Meet2147/touch_smart_mirror/pics/smart-mirror-1.jpg

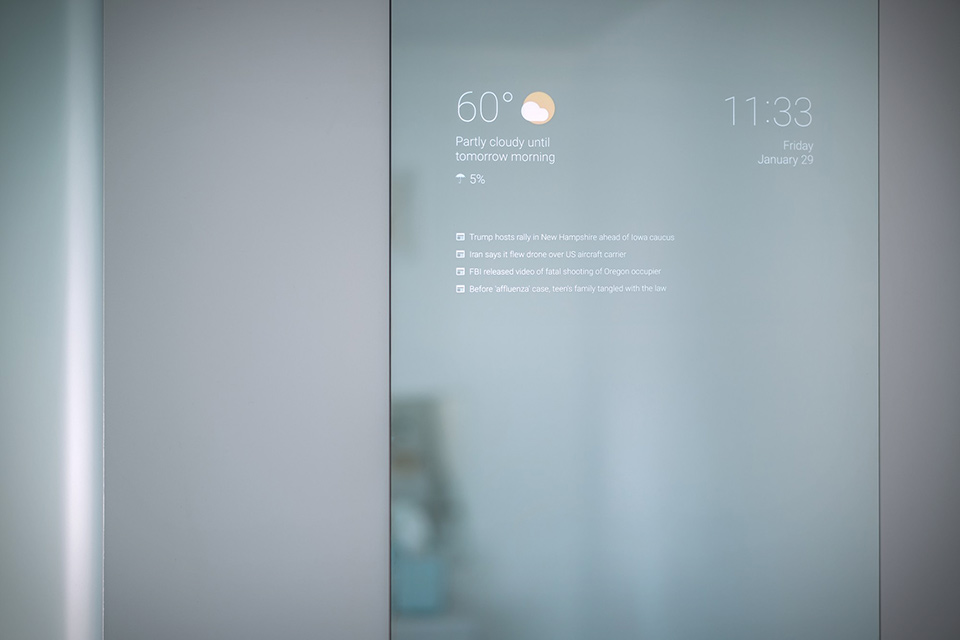
pics/smart-mirror-1.jpg
