Meet2147/touch_smart_mirror/src/smart_mirror_gui/glow.jpg

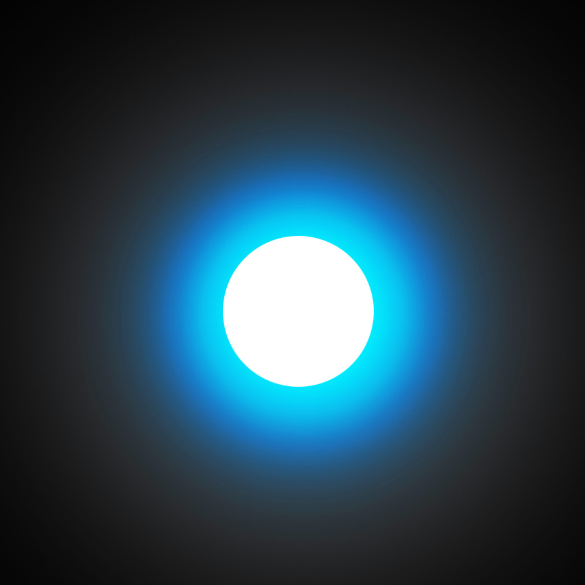
src/smart_mirror_gui/glow.jpg
