Meet2147/touch_smart_mirror/README.md

# touch_smart_mirror
Code and documnents for Custom Touch Screen Smart Mirror
