Meet2147/touch_smart_mirror/docs/Skey_Concept.pptx

## Touch Screen Smart Mirror

Kyle Skey

## Smart Mirror Concept

- “Smart” Mirror that displays news and information
- Touch screen for App selection
  - (Required) One finger touch with large grid resolution (16x9)
  - (Optional) One finger touch with better resolution
  - (Optional) Two finger touch

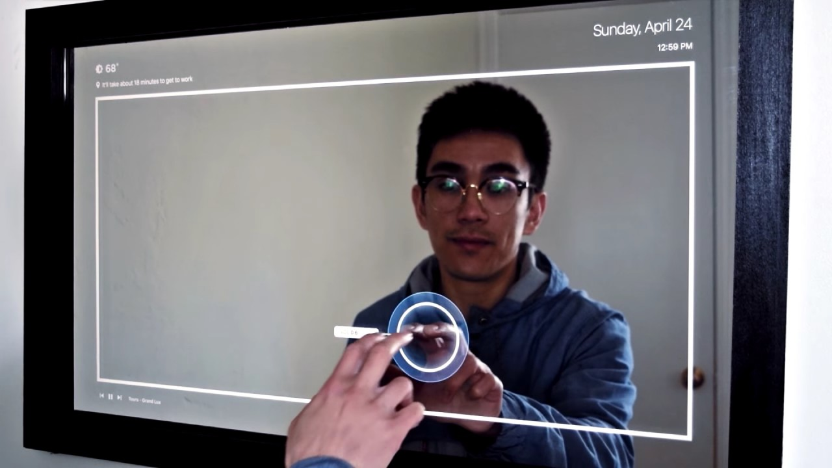
[picture p6: figure]

## Design Elements/IP

IR Grid Touch Screen Grid Assembly

Intellectual Property

- Circuit and PCB Design of Rx/Tx Modules
- Modulation/Filtering Scheme if needed
- Mechanical Packing Design
- Detection Algorithm

Tx Controller

IR Tx Array

IR Beam

Signal Filtering & Integrator

8-Ch ADC
I2C Serial

I2C Protocol

Rx Controller

Computer

Display

IR Rx Array

## IR Grid Theory

- Normal state all sensors are illuminated
- Finger breaks beam in vert/horiz axis
- “Dark” Rx sensors mapped to coordinate system
- Rx controller sends coordinates to computer

Rx IR Phototransistors

Tx IR LEDs

Rx IR Phototransistors

Tx IR LEDs

“Dark”

Finger

“Dark”

## Risks and Concerns

- Mechanical Alignment and Tollerances
- IR Interference
- Serial Protocol Issues
- Funding
- PCB Fab Errors
- Design Errors
- App Development Issues
- Schedule
- Full assembly Integration problems

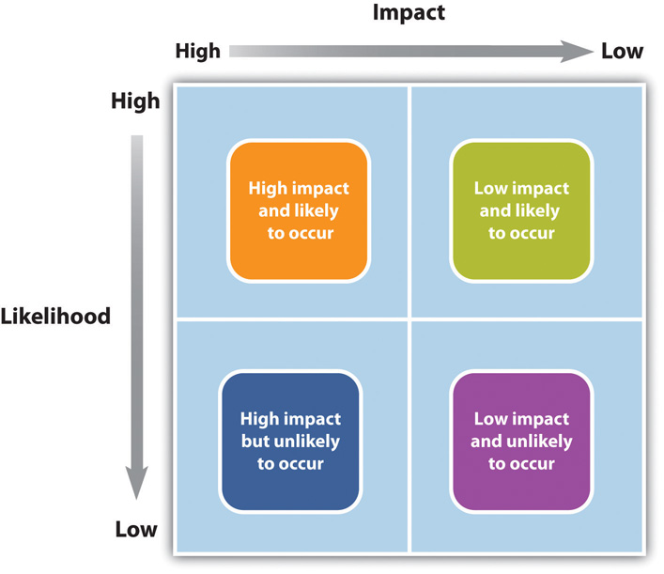
[picture p7: figure]
