Meet2147/touch_smart_mirror/docs/block diagrams.pptx

Tx

Rx

IR TOUCH SCREEN INTERFACE: LOW-LEVEL SENSOR BLOCK DIAGRAM

Tx Demux.

Tx

Rx

+3.3VDC

GND

3-bit Demux Address Bus (3-wires)

Tx Demux

+

Tx

Tx

Tx

Tx

Tx Serial-to-Parallel Shift Reg.

Tx

Tx

Signal from Source

SW Trigger/CLK

Signal to Next Shift Reg

Sensor readings to addressable ADC

ADC3

ADC2

ADC1

ADC0

Rx

Rx

Rx

Rx

Rx

Rx

+

Rx Serial-to-Parallel Shift Reg

Signal from Source

Signal to Next Shift Reg

SW Trigger/CLK

## Slide 2

IR TOUCH SCREEN INTERFACE: HIGH-LEVEL BLOCK DIAGRAM

+3.3VDC

GND

Tx Bank Selector

Tx LED Selector

3-bit addressing

Cathode

Tx Emitter Array

Anode

Anode To ADC (8 ports)

Teensy 3.2
Microcontroller
12 port 16bit ADC
3.3V Out
3.3-5V IN

USB HID

Raspberry Pi

Rx Sensor Array

Rx Bank Selector

Cathode

CLK

HDMI

Display

Horiz/Vert Init Signal

Horiz/Vert Ret Signal

AC Power

## Slide 3

Tx Bank Selector

Tx LED Selector

3-bit addressing

Cathode

Tx Emitter Array

Anode

Teensy 3.2
Microcontroller

Anode To ADC (8 ports)

USB HID

Display Interface

Rx Sensor Array

Rx Bank Selector

Cathode

Horiz/Vert Init Signal

Horiz/Vert Ret Signal

## Slide 4

IR TOUCH SCREEN INTERFACE: BASIC FLOW CHART

Select First Horiz Sensor Bank
(SW Trigger/Clock Pulse increments Shift Register)

Select Tx Sensor (n)
(Universal Demux Address Bus)

Read Rx ADC (n)
Low Number (Light)
High Number (Blocked)

Store Value in SW Array

Repeat Process for Vertical

SW Interrupt Triggers End of Sensors for Horiz

Select Next Sensor Bank (SW Trigger increments Shift Register)

Use Index of High Reading to Determine Position

Repeat Sensor Select and ADC Read for n Sensors

SW Interrupt Triggers End of Sensors for Vertical

Parse Horiz/Vertical Value Arrays for High ADC Readings

Apply Mean Smoothing Algorithm

Send Mouse Commands to Computer

Repeat Process
