Meet2147/touch_smart_mirror/pics/flow_chart.png

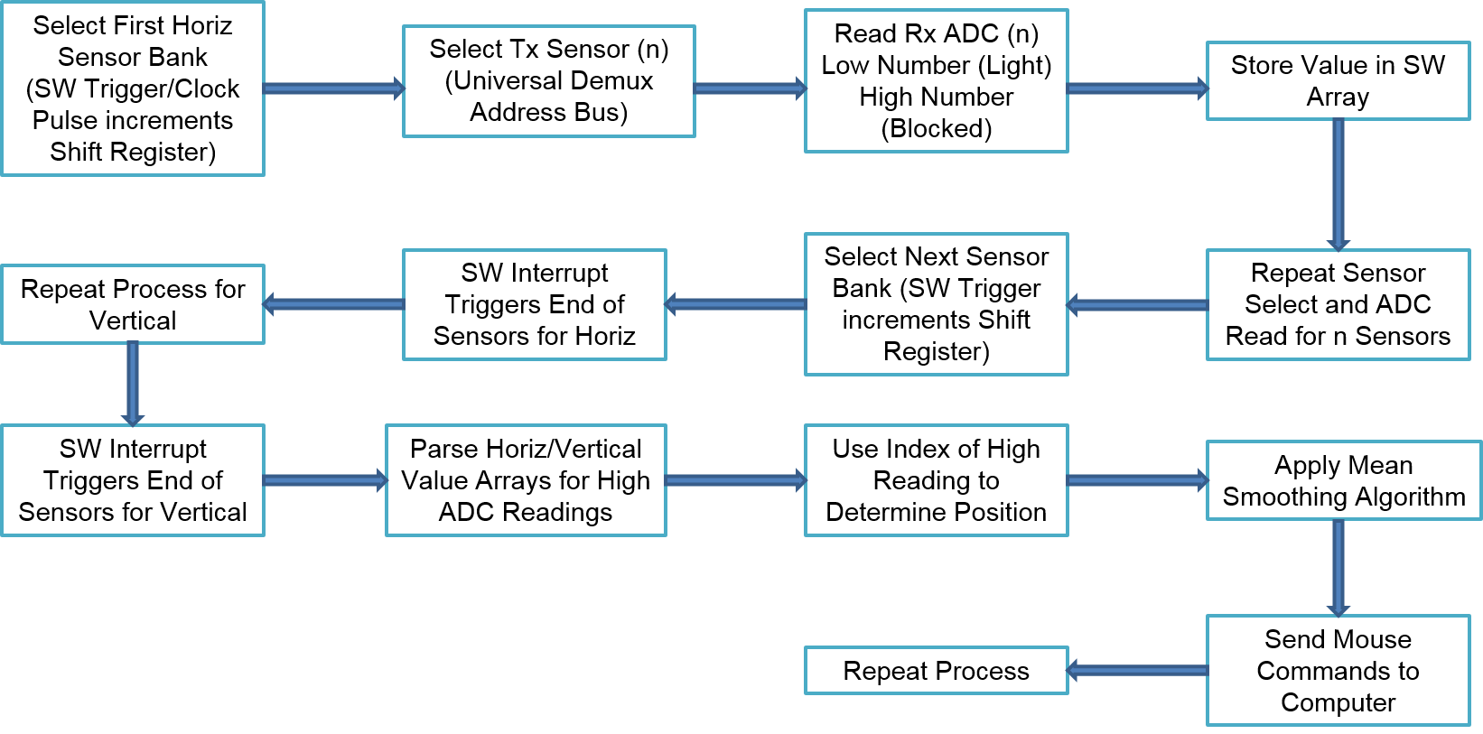
pics/flow_chart.png
