Meet2147/touch_smart_mirror/src/smart_mirror_gui/glow2.jpg

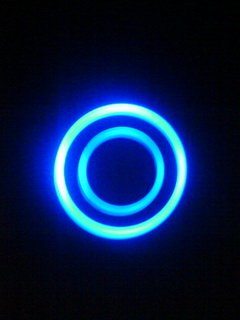
src/smart_mirror_gui/glow2.jpg
