Meet2147/touch_smart_mirror/schematics/board_interconnect_layout.asc

U3: 74hct164
U5: 74hct164
U7: 74hct164
U9: 74hct164
U11: 74hct164
U13: 74hct164
U15: 74hct164
U18: 74hct164
U19: 74hct138
U20: 74hct164
U21: 74hct138
U22: 74hct164
U23: 74hct138
U24: 74hct164
U25: 74hct138
U26: 74hct164
U27: 74hct138
U28: 74hct164
U29: 74hct138
U30: 74hct164
U31: 74hct138
IN (Female)
OUT (Male)
H_SIG_SOURCE
V_SIG_SOURCE
RX Sensor Board
V_SIG_RET
CLK
RESET
SIG_PASS
SIG_PASS
A0
A1
A2
Rx0
Rx1
Rx2
Rx3
Rx4
Rx5
Rx6
Rx7
+3.3V
GND
IN (Female)
OUT (Male)
H_SIG_SOURCE
V_SIG_SOURCE
RX Sensor Board
V_SIG_RET
CLK
RESET
SIG_PASS
SIG_PASS
A0
A1
A2
Rx0
Rx1
Rx2
Rx3
Rx4
Rx5
Rx6
Rx7
+3.3V
GND
IN (Female)
OUT (Male)
H_SIG_SOURCE
V_SIG_SOURCE
RX Sensor Board
V_SIG_RET
CLK
RESET
SIG_PASS
SIG_PASS
A0
A1
A2
Rx0
Rx1
Rx2
Rx3
Rx4
Rx5
Rx6
Rx7
+3.3V
GND
IN (Female)
OUT (Male)
H_SIG_SOURCE
V_SIG_SOURCE
RX Sensor Board
V_SIG_RET
CLK
RESET
SIG_PASS
SIG_PASS
A0
A1
A2
Rx0
Rx1
Rx2
Rx3
Rx4
Rx5
Rx6
Rx7
+3.3V
GND
IN (Female)
OUT (Male)
H_SIG_SOURCE
V_SIG_SOURCE
RX Sensor Board
V_SIG_RET
CLK
RESET
SIG_PASS
SIG_PASS
A0
A1
A2
Rx0
Rx1
Rx2
Rx3
Rx4
Rx5
Rx6
Rx7
+3.3V
GND
IN (Female)
OUT (Male)
H_SIG_SOURCE
V_SIG_SOURCE
RX Sensor Board
V_SIG_RET
CLK
RESET
SIG_PASS
SIG_PASS
A0
A1
A2
Rx0
Rx1
Rx2
Rx3
Rx4
Rx5
Rx6
Rx7
+3.3V
GND
IN (Female)
OUT (Male)
H_SIG_SOURCE
V_SIG_SOURCE
RX Sensor Board
V_SIG_RET
CLK
RESET
SIG_PASS
SIG_PASS
A0
A1
A2
Rx0
Rx1
Rx2
Rx3
Rx4
Rx5
Rx6
Rx7
+3.3V
GND
H_SIG_SOURCE
CLK
RESET
SIG_PASS
SIG_PASS
Tx Emitter Board
IN (Female)
OUT (Male)
A0
A1
A2
+3.3V
GND
H_SIG_SOURCE
CLK
RESET
SIG_PASS
SIG_PASS
Tx Emitter Board
IN (Female)
OUT (Male)
A0
A1
A2
+3.3V
GND
H_SIG_SOURCE
CLK
RESET
SIG_PASS
SIG_PASS
Tx Emitter Board
IN (Female)
OUT (Male)
A0
A1
A2
+3.3V
GND
H_SIG_SOURCE
CLK
RESET
SIG_PASS
SIG_PASS
Tx Emitter Board
IN (Female)
OUT (Male)
A0
A1
A2
+3.3V
GND
H_SIG_SOURCE
CLK
RESET
SIG_PASS
SIG_PASS
Tx Emitter Board
IN (Female)
OUT (Male)
A0
A1
A2
+3.3V
GND
H_SIG_SOURCE
CLK
RESET
SIG_PASS
SIG_PASS
Tx Emitter Board
IN (Female)
OUT (Male)
A0
A1
A2
+3.3V
GND
H_SIG_SOURCE
CLK
RESET
SIG_PASS
SIG_PASS
Tx Emitter Board
IN (Female)
OUT (Male)
A0
A1
A2
+3.3V
GND
H_SIG_SOURCE
V_SIG_SOURCE
V_SIG_RET
CLK
RESET
A0
A1
A2
Rx0
Rx1
Rx2
Rx3
Rx4
Rx5
Rx6
Rx7
+3.3V
GND
H_SIG_RET
LT/Lower Corner Board
LT/Upper Corner Board
RT/Lower Corner Board
RT/Upper Corner Board
OUT (Male)
IN (Female)
IN (Female)
OUT (Male)
OUT (Male)
IN (Female)
IN (Female)
OUT (Male)
RX Sensor Array
RX Sensor Array
RX Sensor Array
RX Sensor Array
RX Sensor Array
RX Sensor Array
RX Sensor Array
