Meet2147/touch_smart_mirror/schematics/Rx_Tx_IO_Layout.asc

U1: 74hct164
U2: 74hct138
U17: 74hct138
U33: 74hct164
H_SIG_SOURCE
CLK
RESET
SIG_PASS
SIG_PASS
IN (Female)
OUT (Male)
H_SIG_SOURCE
V_SIG_SOURCE
RX Sensor Board
V_SIG_RET
CLK
RESET
SIG_PASS
SIG_PASS
Tx Emitter Board
IN (Female)
OUT (Male)
A0
A1
A2
Rx0
Rx1
Rx2
Rx3
Rx4
Rx5
Rx6
Rx7
+3.3V
GND
A0
A1
A2
+3.3V
GND
