Meet2147/touch_smart_mirror/schematics/clocking.asc

U1: 74hct164
U2: 74hct164
U3: 74hct164
U4: 74hct164
U5: 74hct164
U6: 74hct164
U7: 74hct164
U8: 74hct164
U9: 74hct164
U10: 74hct164
U11: 74hct164
U12: 74hct164
Named nets: CP, HOUT, HIN, Vout, VIN, VCC, 0, ADC0, ADC1, ADC2, ADC3, ADC4, ADC5, ADC6, ADC7, A0, MR, NP
.inc 74HCT.lib
