Meet2147/touch_smart_mirror/schematics/tx_schematic.asc

D1: LED; QTLP690C
D2: LED; QTLP690C
D3: LED; QTLP690C
D4: LED; QTLP690C
D5: LED; QTLP690C
D6: LED; QTLP690C
D7: LED; QTLP690C
D8: LED; QTLP690C
D9: LED; QTLP690C
D10: LED; QTLP690C
D11: LED; QTLP690C
D12: LED; QTLP690C
D13: LED; QTLP690C
D14: LED; QTLP690C
D15: LED; QTLP690C
D16: LED; QTLP690C
D17: LED; QTLP690C
D18: LED; QTLP690C
D19: LED; QTLP690C
D20: LED; QTLP690C
D21: LED; QTLP690C
D22: LED; QTLP690C
D23: LED; QTLP690C
D24: LED; QTLP690C
D25: diode; 1N4001
M1: pmos; BSS84
M2: pmos; BSS84
M3: pmos; BSS84
M4: pmos; BSS84
M5: pmos; BSS84
M6: pmos; BSS84
M7: pmos; BSS84
M8: pmos; BSS84
Q1: npn; 2N3904
Q2: npn; 2N3904
Q3: npn; 2N3904
R1: res; 1k
R2: res; 1k
R3: res; 1k
R4: res; 1k
R5: res; 1k
R6: res; 1k
R7: res; 1k
R8: res; 1k
R9: res; 1k
R10: res; 1k
R11: res; 1k
R20: res; 33
R21: res; 33
R22: res; 33
U1: 74hct138
U2: 74hct164
V1: voltage; 5
V2: voltage; PULSE(0 5 1n 1n 1n 0.5m 1m 1000)
V3: voltage; PULSE(0 5 1n 1n 1n 1m 2m 1000)
V4: voltage; PULSE(0 5 1n 1n 1n 2m 4m 1000)
V5: voltage; PULSE(0 5 1n 1n 1n 1m 2m 1)
V6: voltage; PULSE(0 5 0.5m 1n 1n 1m 4m 10000)
Named nets: 0
.model QED123 D(Ron=0.1n Roff=1G Vfwd=1.7 type=LED)
.inc 74HCT.lib
.tran 0 32m 0 startup
