Meet2147/touch_smart_mirror/(list of files, drawings)

Other design files:
schematics/connector.pcb
schematics/cornerboard1_plugfoo.pcb
schematics/design package/cornerboard1.pcb
schematics/design package/cornerboard2.pcb
schematics/design package/RxBoard_revD.pcb
schematics/design package/TxBoard_revD.pcb
schematics/LEDHolderBoard.pcb
schematics/RxBoard.pcb
schematics/RxBoard_revA.pcb
schematics/RxBoard_revB.pcb
schematics/RxBoard_revB_messaroudn.pcb
schematics/RxBoard_revC.pcb
schematics/TxBoard.pcb
schematics/TxBoard_revA.pcb
schematics/TxBoard_revB.pcb
schematics/TxBoard_revC.pcb
