Meet2147/touch_smart_mirror/(commit log)

2016-09-26 Added PCB Layout for demo board
    [LEDHolderBoard.pcb, project BOM.xlsx]
2017-02-04 Updates for phase 2
    [RxBoard.pcb, RxBoard_revA.pcb, RxBoard_revB.pcb, TxBoard.pcb, TxBoard_revA.pcb, TxBoard_revB.pcb, TxBoard_revC.pcb, rx_board.sch]
2017-04-07 Added GUI code and final schematics
    [RxBoard_revB.pcb, RxBoard_revB_messaroudn.pcb, RxBoard_revC.pcb, RxBoard_revD.pcb, Rx_tx_lt_lower.sch, TxBoard_revC.pcb, TxBoard_revD.pcb, connector.pcb]
